ClusterM/ibutton/(threads)

Thread 3 (2025-03-13):

RFID

Fleen5l77, 2025-03-13:
Понимаю немного другое, но по моему было бы интересно бы добавить поддержку 125 килогерц и 13,56 МГц.

125 можно сделать на модифицированном rdm6300

ClusterM, 2025-03-14:
Ну это уже скорее совсем другой проект :)

Closed 2025-03-14.
