ClusterM/ibutton/(list of files, drawings)

Other design files:
ibutton.lay6
