ClusterM/ibutton/ibutton.sch

## KiCad design ibutton.sch (2014-01-22)

Schematic: ibutton.sch

Parts:
BT1: BATTERY
C1, C2, C3: 0.1uF
CON1: USB-MINI-B
D1, D2: DIODESCH
IC1: ATMEGA8-AI; TQFP32
LEDS: LEDS
P1: IBUTTON
P2: IBUTTON_READER
Q1, Q2: BC847; SOT23
R1, R2, R4, R7, R8: 5K
R3: 750
R5: 100K
R6: 1K
SW1: SW_PUSH
U1: FT232RL
